MickThelosen/Smart-Experience-Sampling/README.md

# Smart Experience Sampling

## Setup

The user manual specifies the steps are needed to setup the system

Button B2 starts the ranging process
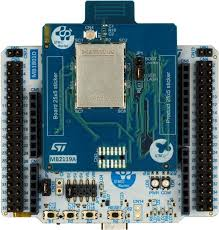
[picture p1: image.png]
