MickThelosen/Smart-Experience-Sampling/Clicker PCB/Clicker_PCB.jpg

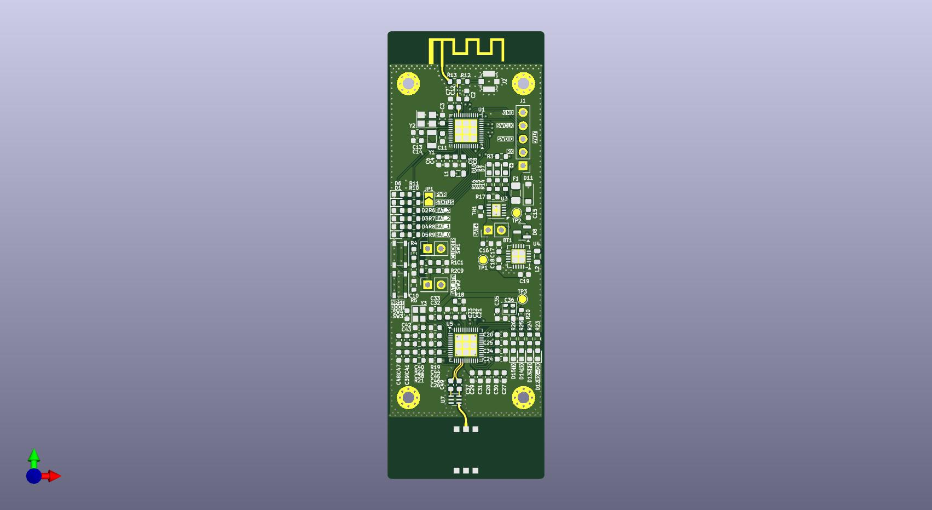
Clicker PCB/Clicker_PCB.jpg
