MickThelosen/Smart-Experience-Sampling/Software/Beacon Visualizer/plattegrond vitality hub 2024.png

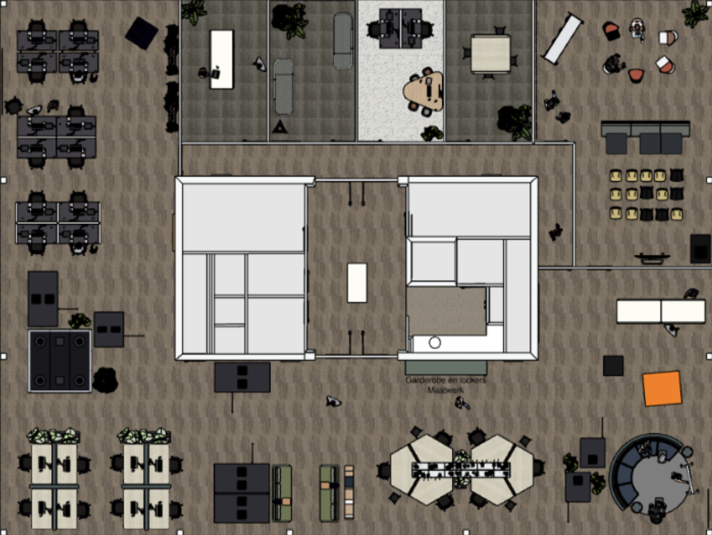
Software/Beacon Visualizer/plattegrond vitality hub 2024.png
