MickThelosen/Smart-Experience-Sampling/Order/SES Order/Mouser/Mouser Complete Order SES.xls

SHOPPING BASKET
This is not an invoice
06-Dec-24 06:26:31
 | Mouser No | Mfr. No | Manufacturer | Customer No | Description | RoHS | Lifecycle | Order Qty. | Price (EUR) | Ext.: (EUR)
1 | 358-SC1152 | SC1152 | Raspberry Pi |  | Wall Mount AC Adapters Raspberry Pi 5 27W USB-C PD PSU EU, White | RoHS Compliant | New Product | 1 | € 11,16 | € 11,16
2 | 358-SC1111 | SC1111 | Raspberry Pi |  | Single Board Computers Raspberry Pi5/4GB | RoHS Compliant | New Product | 1 | € 55,80 | € 55,80
3 | 358-SC1148 | SC1148 | Raspberry Pi |  | Heat Sinks Raspberry Pi Active Cooler | RoHS Compliant | New Product | 1 | € 4,65 | € 4,65
4 | 575-8581000310012000 | 858-10-003-10-012000 | Mill-Max |  | Headers & Wire Housings 4mm target Conn TH with inserts,no pins | RoHS Compliant |  | 10 | € 2,99 | € 29,90
5 | 575-8582200310011101 | 858-22-003-10-011101 | Mill-Max |  | Headers & Wire Housings Thru Hole 4mm Pitch Spring-Load Connect | RoHS Compliant |  | 10 | € 6,16 | € 61,60
6 | 358-SC0532 | SC0532 | Raspberry Pi |  | HDMI Cables 789RP-19041601B Micro-HDMI/M to HDMI-A/M Cable, 2M, Black | RoHS Compliant |  | 1 | € 5,58 | € 5,58
7 | 495-TXLN025-105 | TXLN 025-105 | TRACO Power |  | Switching Power Supplies 25W 5V 5A | RoHS Compliant |  | 1 | € 30,11 | € 30,11
8 | 467-SDSDQAB-016G | SDSDQAB-016G | SanDisk |  | Memory Cards 16GB UHS Class 4 MicroSD Card WD/SD | RoHS Compliant |  | 1 | € 11,99 | € 11,99
9 | 540-MX1A-E1NN | MX1A-E1NN | CHERRY |  | Pushbutton Switches Full Travel (Blue stem), Mech. KeyswitchClick Tactile Feel, 60cNNo LED, No DiodeFrame mount (no fixation pins) | RoHS Compliant |  | 10 | € 0,805 | € 8,05
10 | 540-MX1A-G1NA | MX1A-G1NA | CHERRY |  | Pushbutton Switches MX RGB, Brown Stem, Full Travel Mechanical KeyswitchSoft click Feel, 55cN, clear housingNo DiodeFrame Mount (no fixation pins) | RoHS Compliant |  | 10 | € 1,30 | € 13,00
11 | 12BHC186P-GR | 12BHC186P-GR | Eagle Plastic Devices |  | Cylindrical Battery Contacts, Clips, Holders & Springs 2X18650 PARALLEL CONNECTION | RoHS Compliant |  | 10 | € 3,34 | € 33,40
12 | 166-RVT121HVLNWCA0-B | SM-RVT121HVLNWCA0-B | Riverdi |  | TFT Displays & Accessories 12.1" HB,IPS,LVDS,aTouch CG, Optical Bonding, Anti-UV | RoHS Compliant | New Product | 1 | € 179,84 | € 179,84
13 | 71-CRCW06030000Z0EI | CRCW06030000Z0EI | Vishay |  | Thick Film Resistors - SMD D11/CRCW0603 0R0 ET2 e3 | RoHS Compliant By Exemption |  | 60 | € 0,027 | € 1,62
14 | 80-C0603C100K5HACTU | C0603C100K5HACTU | KEMET |  | Multilayer Ceramic Capacitors MLCC - SMD/SMT 50V 10pF 0603 X8R 0.1 | RoHS Compliant |  | 40 | € 0,019 | € 0,76
15 | 791-0603N120J500CT | 0603N120J500CT | Walsin |  | Multilayer Ceramic Capacitors MLCC - SMD/SMT 50 V 12 pF 5% C0G (NP0) 0603 - 55 C + 125 C | RoHS Compliant |  | 80 | € 0,013 | € 1,04
16 | 791-0603N180J250CT | 0603N180J250CT | Walsin |  | Multilayer Ceramic Capacitors MLCC - SMD/SMT 18pF, +-5%, 25V | RoHS Compliant |  | 20 | € 0,013 | € 0,26
17 | 791-0603N200J160CT | 0603N200J160CT | Walsin |  | Multilayer Ceramic Capacitors MLCC - SMD/SMT 20pF, +-5%, 16V | RoHS Compliant |  | 20 | € 0,027 | € 0,54
18 | 80-C0603C270J5GAC | C0603C270J5GAC | KEMET |  | Multilayer Ceramic Capacitors MLCC - SMD/SMT 50V 27pF C0G 0603 5% | RoHS Compliant |  | 20 | € 0,024 | € 0,48
19 | 791-0603B331K100CT | 0603B331K100CT | Walsin |  | Multilayer Ceramic Capacitors MLCC - SMD/SMT 330pF, +-10%, 10V | RoHS Compliant |  | 40 | € 0,009 | € 0,36
20 | 80-C0603C821K5RAC | C0603C821K5RAC | KEMET |  | Multilayer Ceramic Capacitors MLCC - SMD/SMT 50V 820pF X7R 0603 10% | RoHS Compliant |  | 20 | € 0,054 | € 1,08
21 | 791-0603B103J101CT | 0603B103J101CT | Walsin |  | Multilayer Ceramic Capacitors MLCC - SMD/SMT 0603 MLCC X7R 0.01 uF, +/- 5% 100 V T&R MH | RoHS Compliant |  | 20 | € 0,016 | € 0,32
22 | 80-C0603C104M4RAUTO | C0603C104M4RACAUTO | KEMET |  | Multilayer Ceramic Capacitors MLCC - SMD/SMT 16V 0.1uF X7R 0603 20% AEC-Q200 | RoHS Compliant |  | 440 | € 0,02 | € 8,80
23 | 963-MLAST168SB7105KT | MLAST168SB7105KTNA01 | TAIYO YUDEN |  | Multilayer Ceramic Capacitors MLCC - SMD/SMT 25V 1uF X7R 0603 10% Medical | RoHS Compliant |  | 40 | € 0,046 | € 1,84
24 | 810-MLZ2012N1R0LT000 | MLZ2012N1R0LT000 | TDK |  | Power Inductors - SMD 1 UH 20% | RoHS Compliant |  | 20 | € 0,055 | € 1,10
25 | 187-CL10A106MQ8NNND | CL10A106MQ8NNND | Samsung Electro-Mechanics |  | Multilayer Ceramic Capacitors MLCC - SMD/SMT 10uF+/-20% 6.3V X5R 0603 | RoHS Compliant |  | 40 | € 0,061 | € 2,44
26 | 810-MLZ2012M100WTD25 | MLZ2012M100WTD25 | TDK |  | Power Inductors - SMD 10uH 611mohms 350mA AEC-Q200 | RoHS Compliant |  | 20 | € 0,073 | € 1,46
27 | 187-CL10A226MP8NUNE | CL10A226MP8NUNE | Samsung Electro-Mechanics |  | Multilayer Ceramic Capacitors MLCC - SMD/SMT 22uF+/-20% 10V X5R 1 0603 | RoHS Compliant |  | 40 | € 0,092 | € 3,68
28 | 81-GRM188R60J476ME5D | GRM188R60J476ME15D | Murata |  | Multilayer Ceramic Capacitors MLCC - SMD/SMT 47 uF 6.3 VDC 20% 0603 X5R | RoHS Compliant |  | 20 | € 0,143 | € 2,86
29 | 755-ESR03EZPF2700 | ESR03EZPF2700 | ROHM Semiconductor |  | Thick Film Resistors - SMD 0603 270ohm 1% Anti Surge AEC-Q200 | RoHS Compliant By Exemption |  | 20 | € 0,114 | € 2,28
30 | 791-WR06X4700FTL | WR06X4700FTL | Walsin |  | Thick Film Resistors - SMD 470 OHM 1% | RoHS Compliant By Exemption |  | 140 | € 0,003 | € 0,42
31 | 71-CRCW06031K00FKEE | CRCW06031K00FKEE | Vishay |  | Thick Film Resistors - SMD D11/CRCW0603 100 1K 1% ET8 e3 | RoHS Compliant By Exemption |  | 20 | € 0,031 | € 0,62
32 | 71-CRCW060310K0FKED | CRCW060310K0FKED | Vishay |  | Thick Film Resistors - SMD D11/CRCW0603 100 10K 1% ET3 E3 | RoHS Compliant By Exemption |  | 100 | € 0,009 | € 0,90
33 | 667-ERT-J1VR103J | ERT-J1VR103J | Panasonic |  | NTC (Negative Temperature Coefficient) Thermistors 10K OHM 5% | RoHS Compliant |  | 20 | € 0,109 | € 2,18
34 | 660-RK73B1JTTD163J | RK73B1JTTD163J | KOA Speer |  | Thick Film Resistors - SMD 16K OHM 5% | RoHS Compliant By Exemption |  | 20 | € 0,01 | € 0,20
35 | 603-RT0603FRE13100KL | RT0603FRE13100KL | YAGEO |  | Thin Film Resistors - SMD 1/10W 100K ohm 1% 50ppm | RoHS Compliant By Exemption |  | 20 | € 0,015 | € 0,30
36 | 732-22532MF1Z-ACX | TSX-3225 32.0000MF10Z-ACX | Epson |  | Crystals TSX-3225 32.0000MF10Z-ACX: XTAL +/-10PPM +/-10PPM-20 75C 9.0PF ANY TR | RoHS Compliant |  | 20 | € 0,684 | € 13,68
37 | 815-ABM1016538.4MT3 | ABM10-165-38.400MHz-T3 | ABRACON |  | Crystals 38.4 MHZ OSC MEMS H/LVCMOS | RoHS Compliant |  | 20 | € 1,01 | € 20,20
38 | 603-RT0603DRD0711KL | RT0603DRD0711KL | YAGEO |  | Thin Film Resistors - SMD 11K OHM .5% 25PPM 1/10W | RoHS Compliant By Exemption |  | 20 | € 0,045 | € 0,90
39 | 80-C0603C129B4HACTU | C0603C129B4HACTU | KEMET |  | Multilayer Ceramic Capacitors MLCC - SMD/SMT 16V 1.2pF X8R 0603 0.1pF | RoHS Compliant |  | 20 | € 0,05 | € 1,00
40 | 187-CL10B225KP8NNNC | CL10B225KP8NNNC | Samsung Electro-Mechanics |  | Multilayer Ceramic Capacitors MLCC - SMD/SMT 2.2uF+/-10% 10V X7R 0603 | RoHS Compliant |  | 20 | € 0,037 | € 0,74
41 | 963-JMK107BJ475MA-T | JMK107BJ475MA-T | TAIYO YUDEN |  | Multilayer Ceramic Capacitors MLCC - SMD/SMT RPLCMT PN 963-MSASJ105BB5475MF 6.3V 4.7uF X5R 0603 20 % | RoHS Compliant |  | 80 | € 0,039 | € 3,12
42 | 791-RMC1/16-512JTP | RMC1/16-512JTP | Kamaya |  | Thick Film Resistors - SMD 0603 5K1 5% | RoHS Compliant By Exemption |  | 100 | € 0,004 | € 0,40
43 | 78-BZT52C5V6-E3-08 | BZT52C5V6-E3-08 | Vishay |  | Zener Diodes 5.6 Volt 0.5W 5% | RoHS Compliant |  | 20 | € 0,08 | € 1,60
44 | 963-AH086M555003-T | AH086M555003-T | TAIYO YUDEN |  | Antennas 963-TSA5NA6L5G55NS00 RPLCMT PN 3.5 - 5.6GHZ WIMAX | RoHS Compliant |  | 20 | € 5,31 | € 106,20
45 | 583-BAT54C | BAT54C | Rectron |  | Schottky Diodes & Rectifiers SOT23 0.2A 30V Schot tky Dblr | RoHS Compliant |  | 20 | € 0,246 | € 4,92
46 | 611-PTS810SJS250SMTR | PTS810SJS250SMTRLFS | C&K Switches |  | Tactile Switches SWITCH TACTILE | RoHS Compliant | Factory Special Order | 40 | € 0,345 | € 13,80
47 | 772-DW1000-I-TR13 | DW1000-I-TR13 | Qorvo |  | RF Transceiver DW1000 UWB Transceiver IC | RoHS Compliant |  | 20 | € 10,40 | € 208,00
48 | 710-150060GS75000 | 150060GS75000 | Wurth Elektronik |  | Standard LEDs - SMD WL-SMCW SMDMono TpVw Waterclr 0603 Green | RoHS Compliant |  | 100 | € 0,113 | € 11,30
49 | 810-HHM1595A1 | HHM1595A1 | TDK |  | Signal Conditioning LTCC BALUN 3000-8000MHz | RoHS Compliant |  | 20 | € 0,315 | € 6,30
50 | 968-ISL91127IRAZ-T | ISL91127IRAZ-T | Renesas Electronics |  | Switching Voltage Regulators High Efficiency Buck/BoostRegulator with 4.25A Switches in a | RoHS Compliant |  | 20 | € 1,76 | € 35,20
51 | 579-MCP73833T-AMI/MF | MCP73833T-AMI/MF | Microchip |  | Battery Management Charge Management Controllers | RoHS Compliant |  | 20 | € 0,977 | € 19,54
52 | 511-MLPF-NRG-01D3 | MLPF-NRG-01D3 | STMicroelectronics |  | Signal Conditioning 2.4 GHz Low Pass Filter matched to BLUENRG-LP-LPS | RoHS Compliant |  | 20 | € 0,238 | € 4,76
53 | 710-150060RS75000 | 150060RS75000 | Wurth Elektronik |  | Standard LEDs - SMD WL-SMCW SMDMono TpVw Waterclr 0603 Red | RoHS Compliant |  | 60 | € 0,132 | € 7,92
54 | 710-150060AS75000 | 150060AS75000 | Wurth Elektronik |  | Standard LEDs - SMD WL-SMCW Mono LED Waterclear 0603Amber | RoHS Compliant |  | 40 | € 0,139 | € 5,56
55 | 710-150060BS75000 | 150060BS75000 | Wurth Elektronik |  | Standard LEDs - SMD WL-SMCW SMDMono TpVw Waterclr 0603 Blue | RoHS Compliant |  | 60 | € 0,144 | € 8,64
56 | 511-STM32WB07CCV6TR | STM32WB07CCV6TR | STMicroelectronics |  | RF System on a Chip - SoC Ultra-low-power Arm Cortex-M0+ MCU 64 MHz 256 Kbytes Flash 64 Kbytes RAM BLE 5.4 | RoHS Compliant | New Product | 20 | € 2,70 | € 54,00
57 | 815-ABS07L-32.7-T | ABS07L-32.768kHz-T | ABRACON |  | Crystals 32.768 KHZ 12.5PF SMD | RoHS Compliant |  | 20 | € 1,20 | € 24,00
58 | 504-PTS18126V260 | PTS18126V260 | Eaton |  | Resettable Fuses - PPTC PPTC 1812 6V 2.6A SMD | RoHS Compliant |  | 20 | € 0,152 | € 3,04
59 | 910-SMDLTB35T4 | SMDLTB35T4 | Chip Quik |  | Solder Solder Paste Sn60/Bi40 T4 35g Syringe 87% Metal Low-Temperature | RoHS Compliant | New Product | 1 | € 24,13 | € 24,13
60 | 910-SMD291/30CC | SMD291/30CC | Chip Quik |  | Soldering Flux TACK FLUX NO CLEAN 30CC SYRINGE | RoHS Compliant |  | 1 | € 34,19 | € 34,19
By submitting your order you agree to these terms and conditions. (https://nl.mouser.com/saleterms) |  |  |  |  |  |  |  |  | Merchandise: | € 1.093,76
Prices are reflected at the date and time shown. |  |  |  |  |  |  |  |  | Delivery Charge: | € 0,00
