MickThelosen/Smart-Experience-Sampling/3D Design Files/Clicker V3.1.step

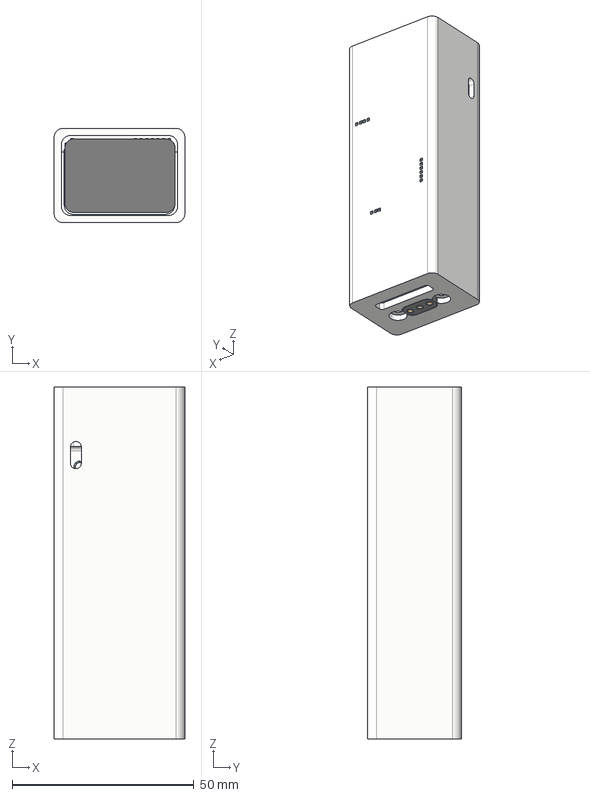
[picture p4: CAD file, 2025-01-19]
3D Design Files/Clicker V3.1.step
36.0 x 26.0 x 96.9 mm
MX Öá °´¼ü¡ä_¨¹ ___¡§1
MX Öá ÖáÌå¨¢¨¬ _¡§¡é¡§__
MXÖá ÖáÌå µ×²¿ ¦Ì¡ Á2__Ä¬ÈÏ_¨¢2____¨¨_
Õë½Å___Ä¬ÈÏ__¨¨ _
LED_0603_1608Metric_1 x 13
Clicker_PCB_PCB
Battery
Button
Outer Shell
Tray
mill-max-858-10-003-10-002000_P8XX-18-014-16-08000X(P803-18-014-16-08 0000)
mill-max-858-10-003-10-002000_1969-X(1969-1-00-15-00-00-03-0) x 3
