MickThelosen/Smart-Experience-Sampling/Clicker PCB/Clicker_PCB.step

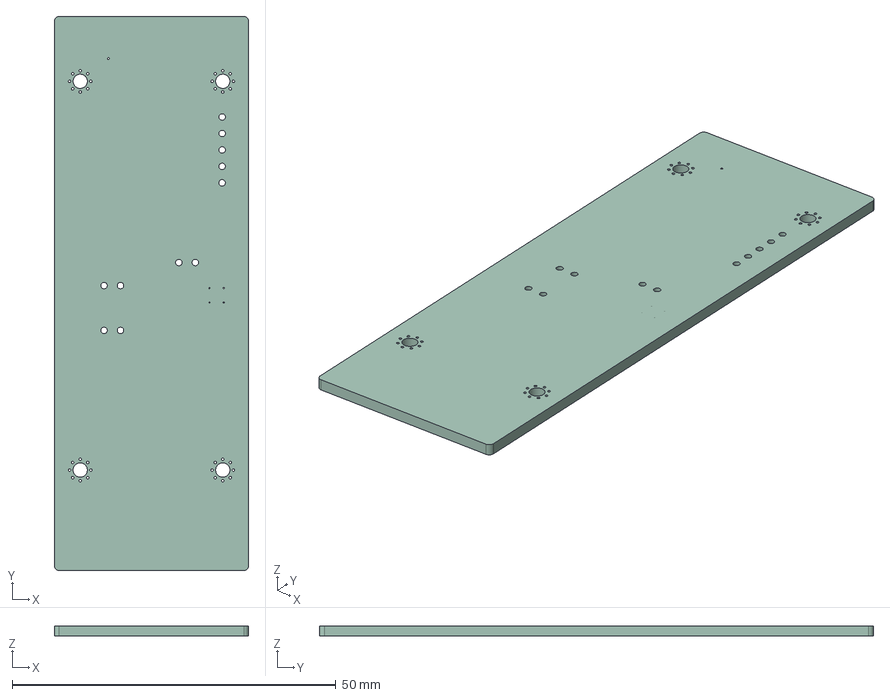
[picture p5: CAD file, 2025-01-19]
Clicker PCB/Clicker_PCB.step
30.0 x 85.5 x 1.60 mm
