MickThelosen/Smart-Experience-Sampling/(list of files, cad)

Other CAD files:
3D Design Files/Clicker V3.1.f3d
