MickThelosen/Smart-Experience-Sampling/Clicker PCB/plots/Clicker_PCB__Assembly.pdf

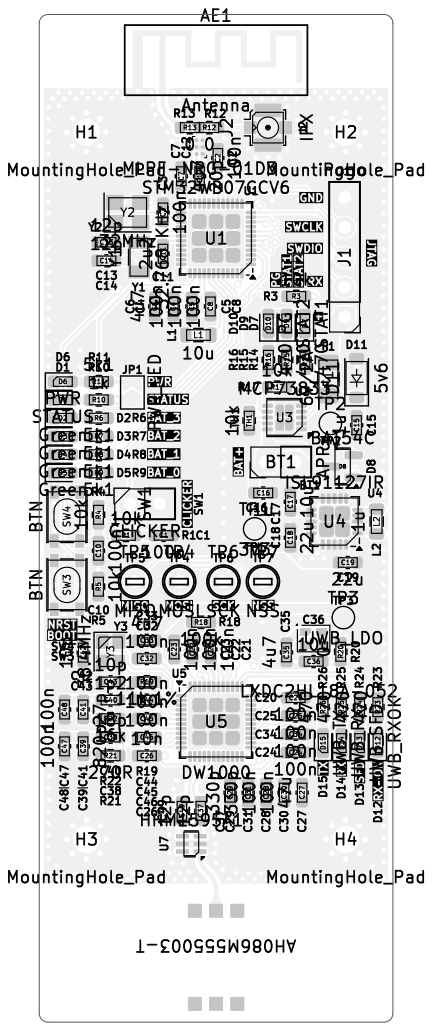
[picture p17: page 1]

1 | 2 | 3 | 4 | 5 | 6

A

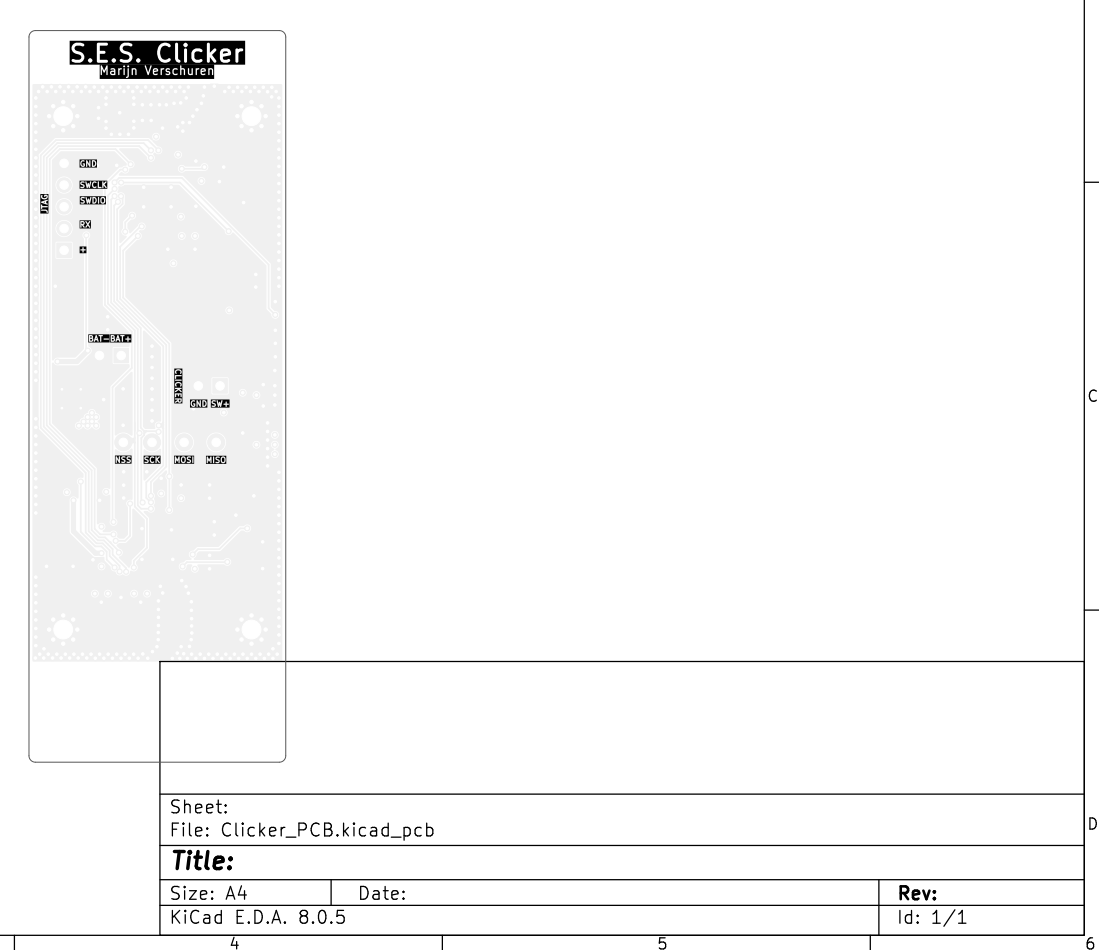
[picture p18: page 2]
D Date: KiCad; E.D.A. 8.0.5 Size: A4; Rev:

Id: 1/1 Title: File: Clicker_PCB.kicad_pcb Sheet:
