MickThelosen/Smart-Experience-Sampling/Clicker PCB/plots/Clicker_PCB.pdf

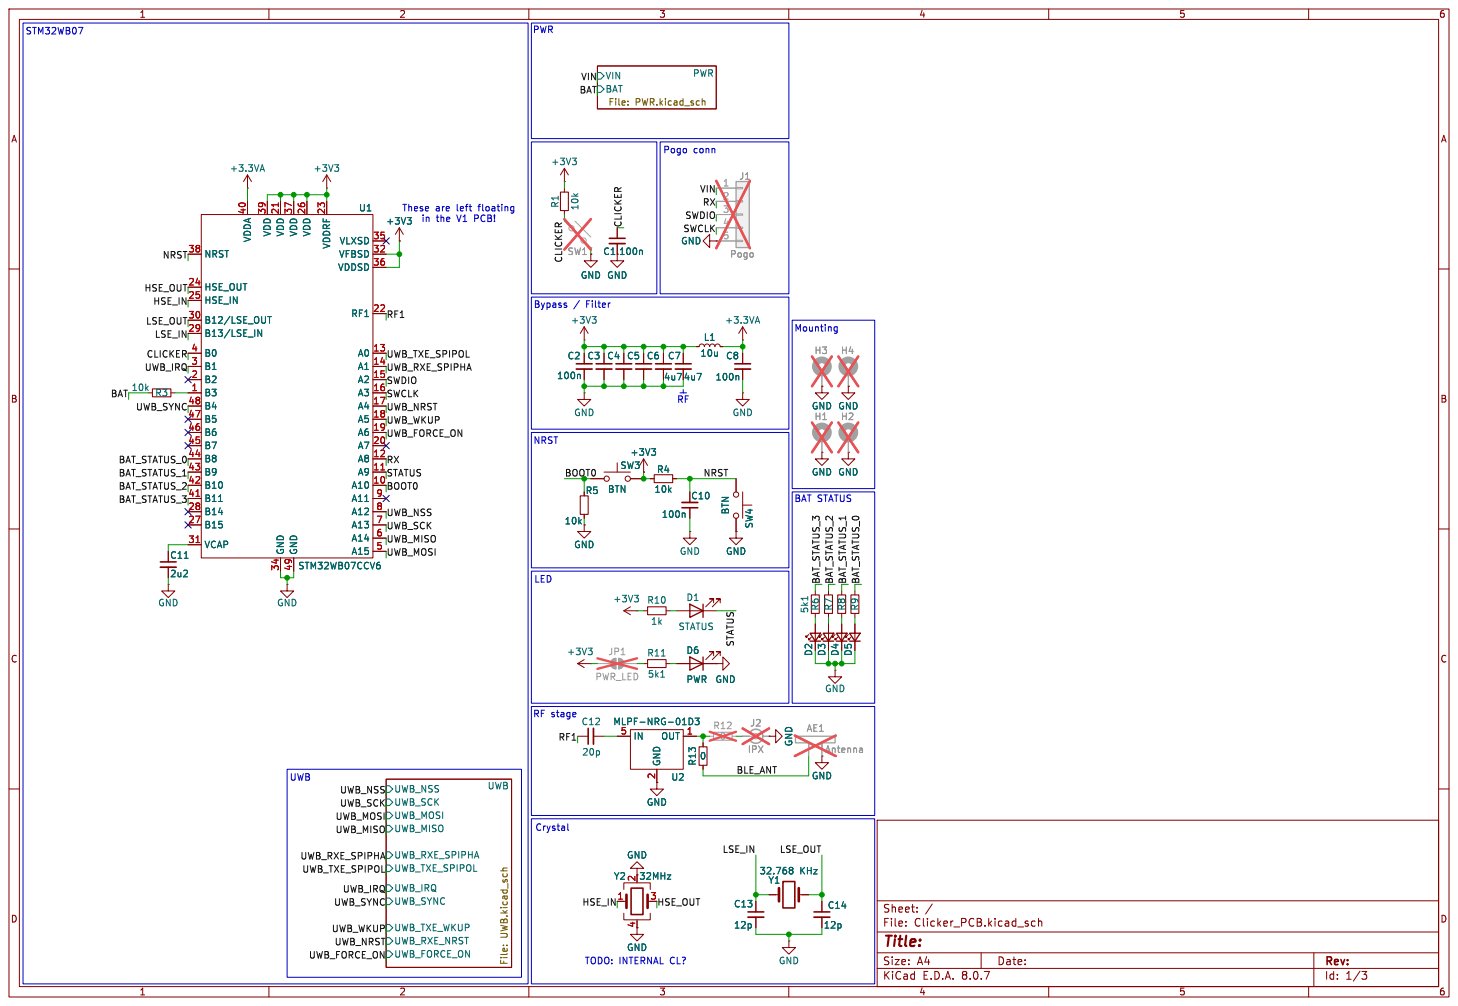
[picture p19: page 1]

These are left floating

Id: 1/3 Title: File: Clicker_PCB.kicad_sch Sheet: / UWB_RXE_SPIPHA UWB_TXE_SPIPOL UWB_SYNC

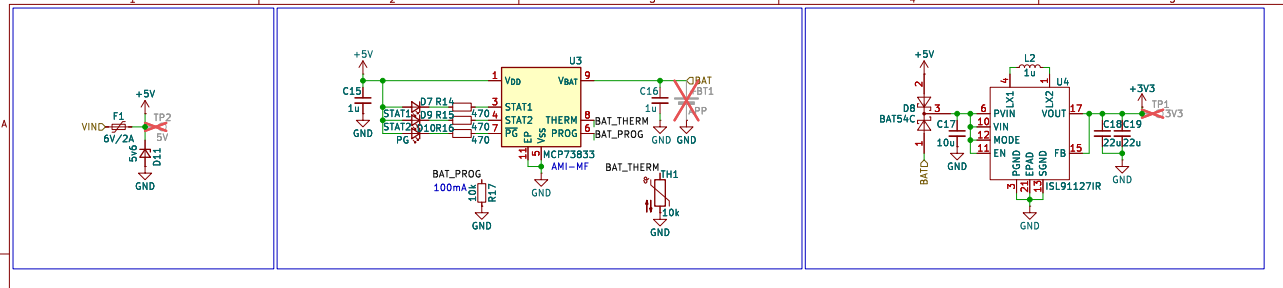
[picture p20: page 2]

1 VIN 10 EN 11 MODE 12 SGND 13 FB 15 VOUT 17 EPAD 21 PGND

Id: 2/3 Title: File: PWR.kicad_sch Sheet: /PWR/

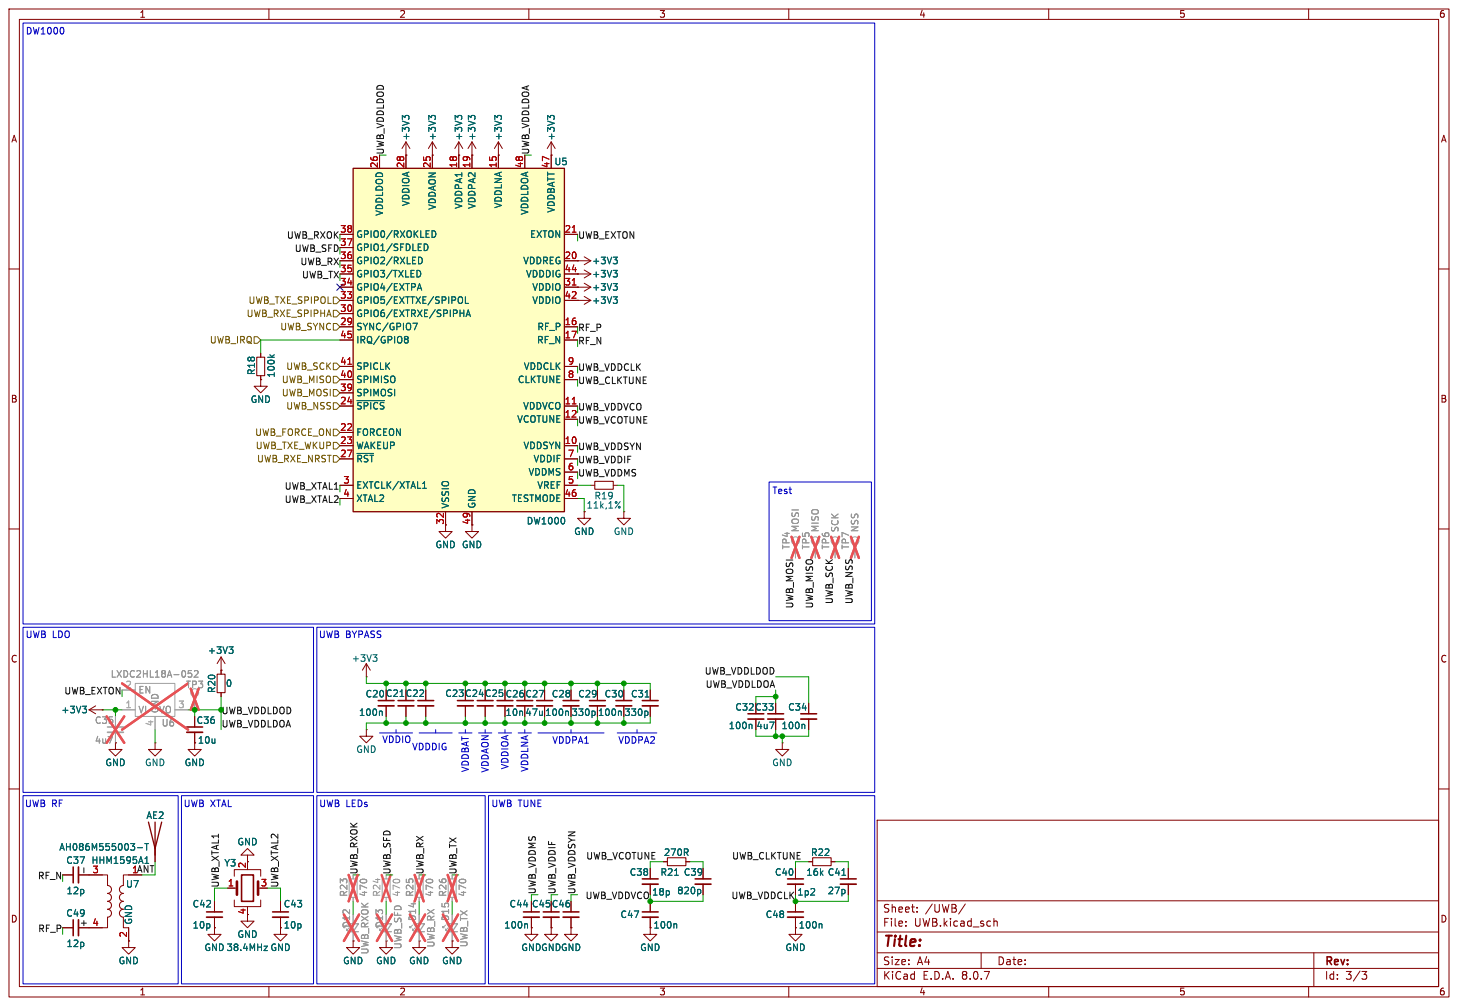
[picture p21: page 3]

Id: 3/3 Title: File: UWB.kicad_sch Sheet: /UWB/ GND GND
