MickThelosen/Smart-Experience-Sampling/Clicker PCB/Clicker_PCB.kicad_pcb

## KiCad design Clicker PCB/Clicker_PCB.kicad_pcb (2025-01-27)

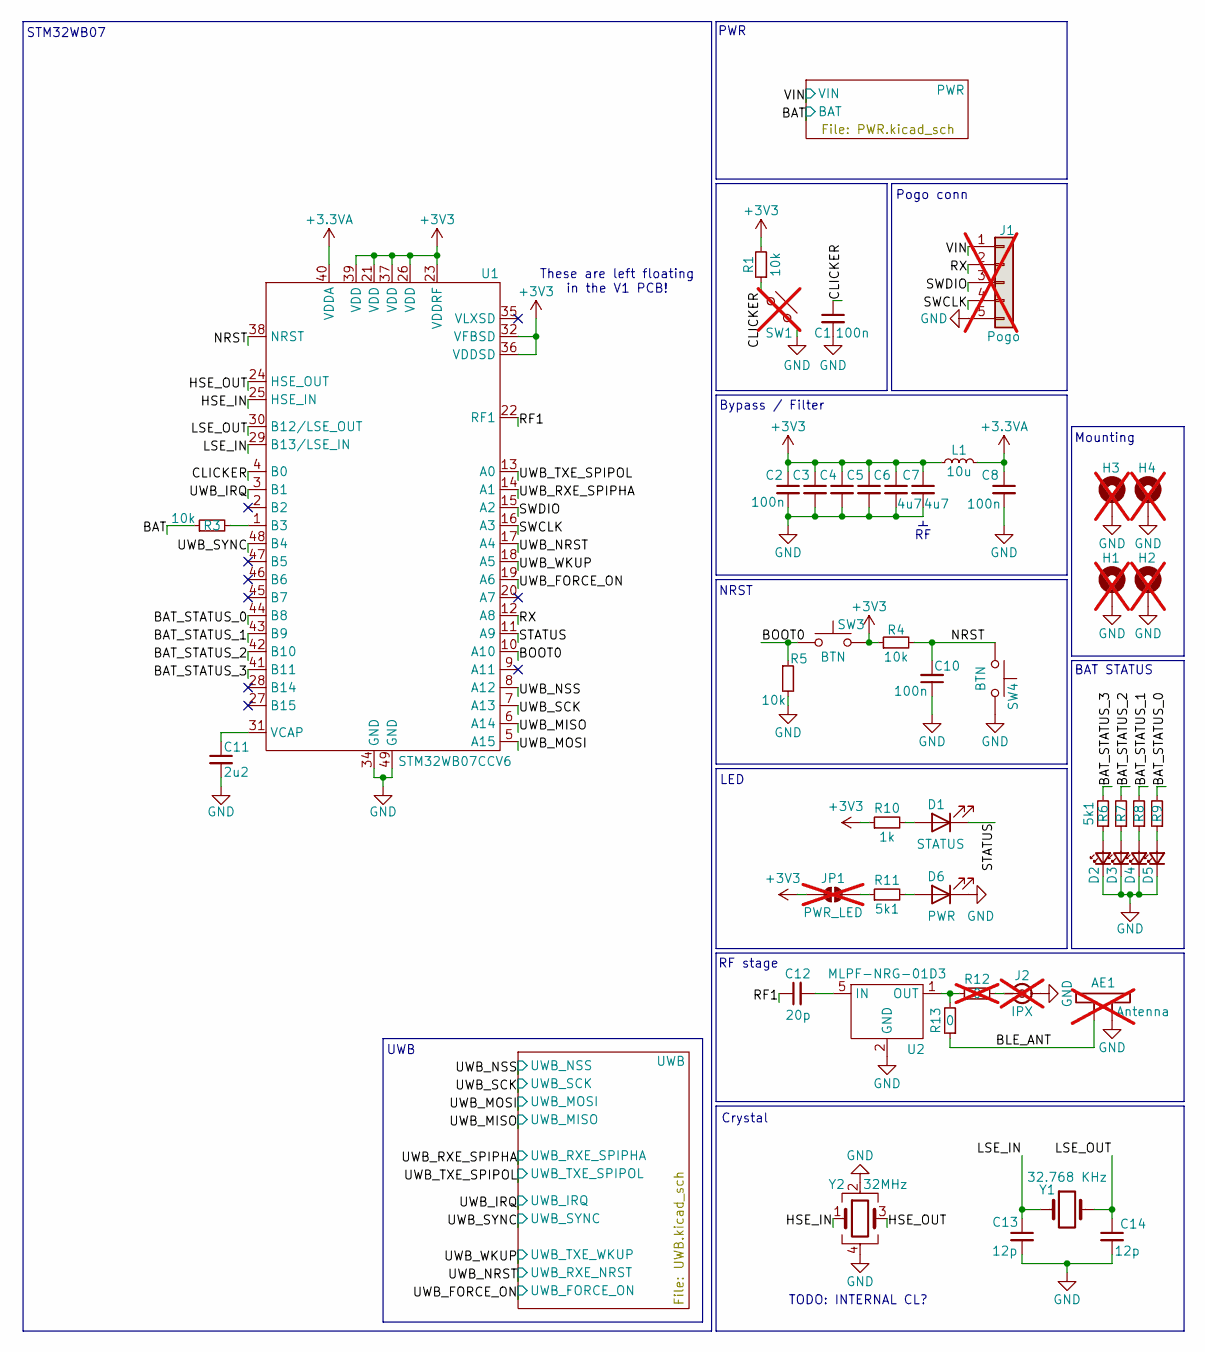
[picture p36: schematic Clicker_PCB.kicad_sch]

Parts:
AE1: Antenna; Texas_SWRA117D_2.4GHz_Right; not fitted
C1, C2, C3, C4, C5, C8, C10: 100n; C_0603_1608Metric; mouser 80-C0603C104M4RAUTO
C6, C7: 4u7; C_0603_1608Metric; mouser 963-JMK107BJ475MA-T
C11: 2u2; C_0603_1608Metric; mouser 187-CL10B225KP8NNNC
C12: 20p; C_0603_1608Metric; LCSC C1547
C13, C14: 12p; C_0603_1608Metric; LCSC C1547
D1: STATUS; LED_0603_1608Metric; mouser 710-150060BS75000
D2, D3, D4, D5: Green; LED_0603_1608Metric; mouser 710-150060GS75000
D6: PWR; LED_0603_1608Metric; mouser 710-150060RS75000
H1, H2, H3, H4: MountingHole_Pad; MountingHole_2.2mm_M2_Pad_Via; not fitted
J1: Pogo; PinHeader_1x05_P2.54mm_Vertical; not fitted
J2: IPX; U.FL_Molex_MCRF_73412-0110_Vertical; not fitted
JP1: PWR_LED; SolderJumper-2_P1.3mm_Open_TrianglePad1.0x1.5mm; not fitted
L1: 10u; L_0805_2012Metric; LCSC C139245
R1, R3, R4, R5: 10k; R_0603_1608Metric; mouser 71-CRCW060310K0FKED
R6, R7, R8, R9, R11: 5k1; R_0603_1608Metric; mouser 791-RMC1/16-512JTP
R10: 1k; R_0603_1608Metric; mouser 71-CRCW06031K00FKEE
R12: 0; R_0603_1608Metric; mouser 71-CRCW06030000Z0EI; not fitted
R13: 0; R_0603_1608Metric; mouser 71-CRCW06030000Z0EI
SW1: CLICKER; PinHeader_2x01_P2.54mm_Vertical; not fitted
SW3, SW4: BTN; SW_SPST_PTS810; LCSC C2681476
U1: STM32WB07CCV6; QFN-48-1EP_6x6mm_P0.4mm_EP4.3x4.3mm; mouser 511-STM32WB07CCV6TR
U2: MLPF-NRG-01D3; CSPG; mouser 511-MLPF-NRG-01D3
Y1: 32.768 KHz; Crystal_SMD_3215-2Pin_3.2x1.5mm; LCSC C32346
Y2: 32MHz; Crystal_SMD_3225-4Pin_3.2x2.5mm; LCSC C9006

Connections:
+3.3VA: C8.1, L1.2, U1.40 (VDDA)
+3V3: C2.1, C3.1, C4.1, C5.1, C6.1, C7.1, JP1.1 (A), L1.1, R1.2, R4.1, R10.1, SW3.2, U1.21 (VDD), U1.23 (VDDRF), U1.26 (VDD), U1.32 (VFBSD), U1.36 (VDDSD), U1.37 (VDD), U1.39 (VDD); also elsewhere on the board
/BAT: R3.1; also elsewhere on the board
/BAT_STATUS_0: R9.2, U1.44 (B8)
/BAT_STATUS_1: R8.2, U1.43 (B9)
/BAT_STATUS_2: R7.2, U1.42 (B10)
/BAT_STATUS_3: R6.2, U1.41 (B11)
/BLE_ANT: AE1.1, R13.1
/BOOT0: R5.1, SW3.1, U1.10 (A10)
/CLICKER: C1.1, R1.1, SW1.1, U1.4 (B0)
/HSE_IN: U1.25 (HSE_IN), Y2.1
/HSE_OUT: U1.24 (HSE_OUT), Y2.3
/LSE_IN: C13.1, U1.29 (B13/LSE_IN), Y1.1
/LSE_OUT: C14.1, U1.30 (B12/LSE_OUT), Y1.2
/NRST: C10.2, R4.2, SW4.1, U1.38 (NRST)
/RF1: C12.1, U1.22 (RF1)
/RX: J1.2, U1.12 (A8)
/STATUS: D1.1 (K), U1.11 (A9)
/SWCLK: J1.4, U1.16 (A3)
/SWDIO: J1.3, U1.15 (A2)
/UWB_FORCE_ON: U1.19 (A6); also elsewhere on the board
/UWB_IRQ: U1.3 (B1); also elsewhere on the board
/UWB_MISO: U1.6 (A14); also elsewhere on the board
/UWB_MOSI: U1.5 (A15); also elsewhere on the board
/UWB_NRST: U1.17 (A4); also elsewhere on the board
/UWB_NSS: U1.8 (A12); also elsewhere on the board
/UWB_RXE_SPIPHA: U1.14 (A1); also elsewhere on the board
/UWB_SCK: U1.7 (A13); also elsewhere on the board
/UWB_SYNC: U1.48 (B4); also elsewhere on the board
/UWB_TXE_SPIPOL: U1.13 (A0); also elsewhere on the board
/UWB_WKUP: U1.18 (A5); also elsewhere on the board
/VIN: J1.1; also elsewhere on the board
GND: AE1.2, C1.2, C2.2, C3.2, C4.2, C5.2, C6.2, C7.2, C8.2, C10.1, C11.2, C13.2, C14.2, D2.1 (K), D3.1 (K), D4.1 (K), D5.1 (K), D6.1 (K), H1.1, H2.1, H3.1, H4.1, J1.5, J2.2 (Ext), R5.2, SW1.2, SW4.2, U1.34 (GND), U1.49 (GND), U2.2 (GND), U2.3 (GND), U2.4 (GND), U2.6 (GND), Y2.2, Y2.4; also elsewhere on the board
unnamed: D1.2 (A), R10.2
unnamed: D2.2 (A), R6.1
unnamed: D3.2 (A), R7.1
unnamed: D4.2 (A), R8.1
unnamed: D5.2 (A), R9.1
unnamed: D6.2 (A), R11.2
unnamed: J2.1 (In), R12.2
unnamed: JP1.2 (B), R11.1
unnamed: R3.2, U1.1 (B3)
unnamed: C11.1, U1.31 (VCAP)
unnamed: C12.2, U2.5 (IN)
unnamed: R12.1, R13.2, U2.1 (OUT)

Notes on the sheet:
Pogo conn
TODO: INTERNAL CL?
BAT STATUS
STM32WB07
These are left floating in the V1 PCB!
LED
Crystal
UWB
PWR
NRST
RF stage
Mounting
Bypass / Filter

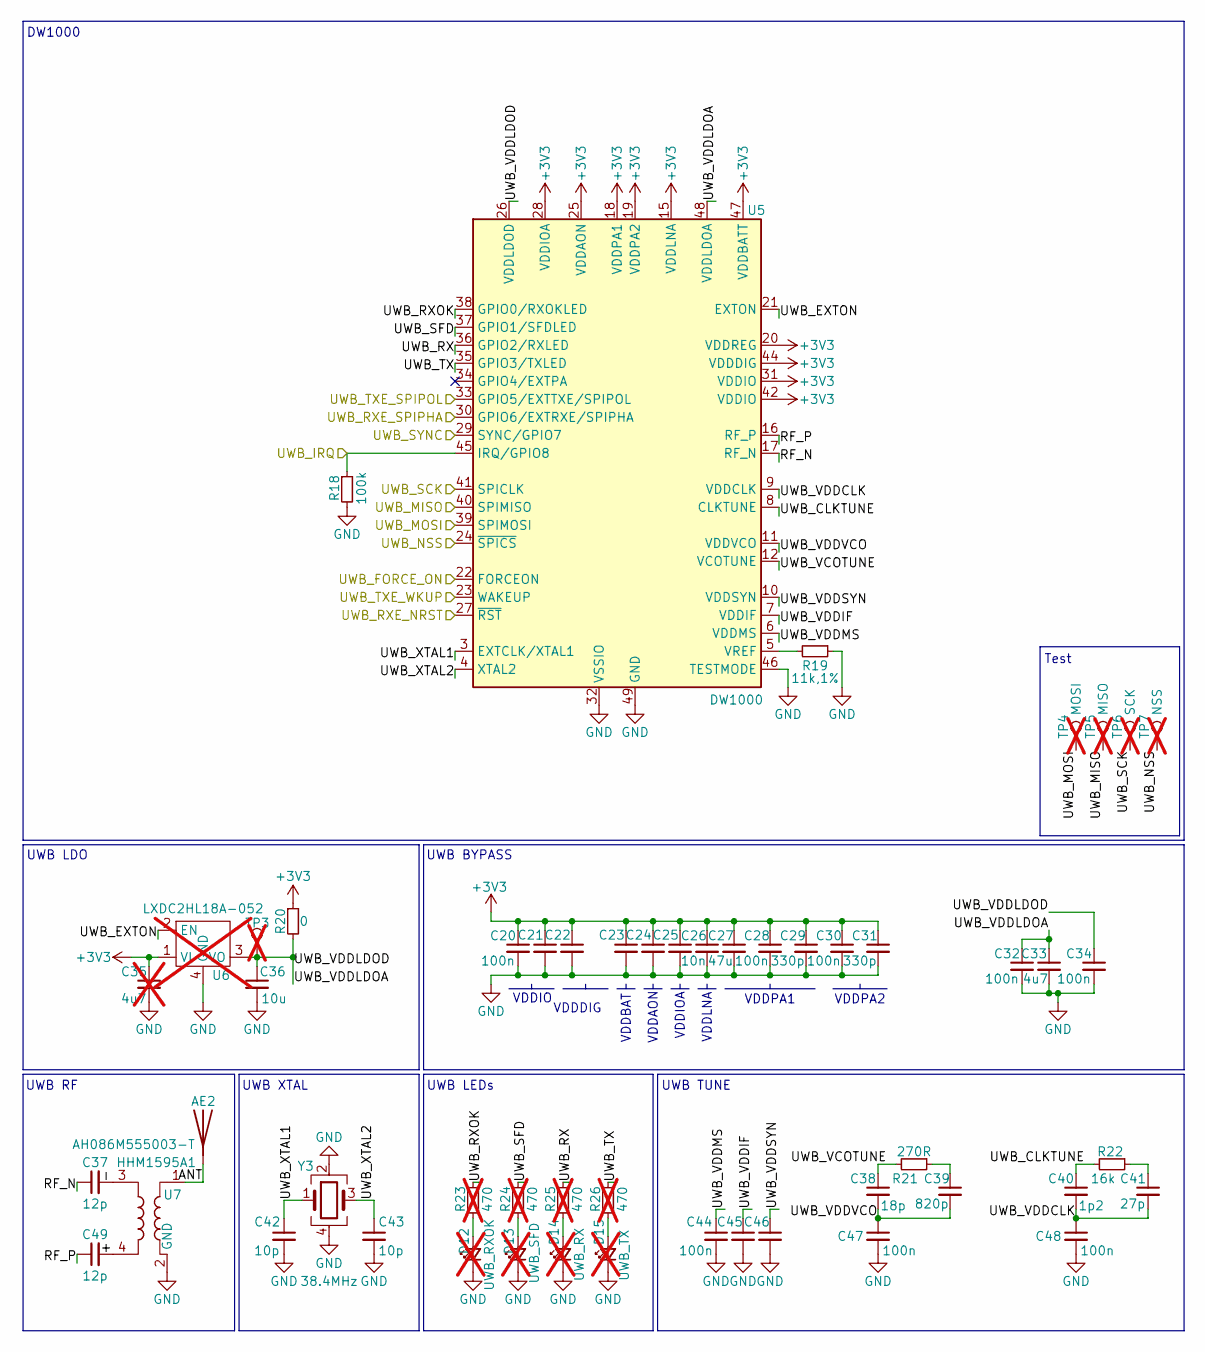
[picture p37: schematic UWB.kicad_sch]

Parts:
AE2: AH086M555003-T; AH086Mx; mouser 963-AH086M555003-T
C20, C21, C22, C23, C24, C25, C28, C30, C32, C34, C44, C45, C46, C47, C48: 100n; C_0603_1608Metric; LCSC C1547
C26: 10n; C_0603_1608Metric; LCSC C1547
C27: 47u; C_0603_1608Metric; LCSC C1547
C29, C31: 330p; C_0603_1608Metric; LCSC C1547
C33: 4u7; C_0603_1608Metric; LCSC C1547
C35: 4u7; C_0603_1608Metric; LCSC C1547; not fitted
C36: 10u; C_0603_1608Metric; LCSC C1547
C37, C49: 12p; C_0603_1608Metric; mouser 791-0603N120J500CT
C38: 18p; C_0603_1608Metric; LCSC C1547
C39: 820p; C_0603_1608Metric; LCSC C1547
C40: 1p2; C_0603_1608Metric; LCSC C1547
C41: 27p; C_0603_1608Metric; LCSC C1547
C42, C43: 10p; C_0603_1608Metric; LCSC C1547
D12: UWB_RXOK; LED_0603_1608Metric; mouser 710-150060GS75000; not fitted
D13: UWB_SFD; LED_0603_1608Metric; mouser 710-150060RS75000; not fitted
D14: UWB_RX; LED_0603_1608Metric; mouser 710-150060BS75000; not fitted
D15: UWB_TX; LED_0603_1608Metric; mouser 710-150060BS75000; not fitted
R18: 100k; R_0603_1608Metric; mouser 603-RT0603FRE13100KL
R19: 11k,1%; R_0603_1608Metric; mouser 603-RT0603DRD0711KL
R20: 0; R_0603_1608Metric; mouser 71-CRCW06030000Z0EI
R21: 270R; R_0603_1608Metric; mouser 755-ESR03EZPF2700
R22: 16k; R_0603_1608Metric; mouser 660-RK73B1JTTD163J
R23, R24, R25, R26: 470; R_0603_1608Metric; mouser 791-WR06X4700FTL; not fitted
TP3: UWB_LDO; TestPoint_Pad_D1.5mm; not fitted
TP4: MOSI; TestPoint_Keystone_5000-5004_Miniature; not fitted
TP5: MISO; TestPoint_Keystone_5000-5004_Miniature; not fitted
TP6: SCK; TestPoint_Keystone_5000-5004_Miniature; not fitted
TP7: NSS; TestPoint_Keystone_5000-5004_Miniature; not fitted
U5: DW1000; QFN-48-1EP_6x6mm_P0.4mm_EP4.2x4.2mm; mouser 772-DW1000-I-TR13
U6: LXDC2HL18A-052; LXDC2HL; mouser 81-LXDC2HL18A-052; not fitted
U7: HHM1595A1; mouser 810-HHM1595A1
Y3: 38.4MHz; Crystal_SMD_2520-4Pin_2.5x2.0mm; mouser 815-ABM1016538.4MT3

Connections:
+3V3: C20.1, C21.1, C22.1, C23.1, C24.1, C25.1, C26.1, C27.1, C28.1, C29.1, C30.1, C31.1, C35.1, R20.1, U5.15 (VDDLNA), U5.18 (VDDPA1), U5.19 (VDDPA2), U5.20 (VDDREG), U5.25 (VDDAON), U5.28 (VDDIOA), U5.31 (VDDIO), U5.42 (VDDIO), U5.44 (VDDDIG), U5.47 (VDDBATT), U6.1 (VI); also elsewhere on the board
/UWB/+: C49.2, U7.4
/UWB/-: C37.2, U7.3
/UWB/ANT: AE2.1 (A), U7.1
/UWB/RF_N: C37.1, U5.17 (RF_N)
/UWB/RF_P: C49.1, U5.16 (RF_P)
/UWB/UWB_CLKTUNE: C40.1, R22.2, U5.8 (CLKTUNE)
/UWB/UWB_EXTON: U5.21 (EXTON), U6.2 (EN)
/UWB/UWB_RX: R25.1, U5.36 (GPIO2/RXLED)
/UWB/UWB_RXOK: R23.1, U5.38 (GPIO0/RXOKLED)
/UWB/UWB_SFD: R24.1, U5.37 (GPIO1/SFDLED)
/UWB/UWB_TX: R26.1, U5.35 (GPIO3/TXLED)
/UWB/UWB_VCOTUNE: C38.1, R21.2, U5.12 (VCOTUNE)
/UWB/UWB_VDDCLK: C40.2, C41.2, C48.1, U5.9 (VDDCLK)
/UWB/UWB_VDDIF: C45.1, U5.7 (VDDIF)
/UWB/UWB_VDDLDOA: C32.1, C33.1, C34.1, C36.1, R20.2, TP3.1, U5.26 (VDDLDOD), U5.48 (VDDLDOA), U6.3 (VO)
/UWB/UWB_VDDMS: C44.1, U5.6 (VDDMS)
/UWB/UWB_VDDSYN: C46.1, U5.10 (VDDSYN)
/UWB/UWB_VDDVCO: C38.2, C39.2, C47.1, U5.11 (VDDVCO)
/UWB/UWB_XTAL1: C42.1, U5.3 (EXTCLK/XTAL1), Y3.1
/UWB/UWB_XTAL2: C43.1, U5.4 (XTAL2), Y3.3
/UWB_FORCE_ON: U5.22 (FORCEON); also elsewhere on the board
/UWB_IRQ: R18.1, U5.45 (IRQ/GPIO8); also elsewhere on the board
/UWB_MISO: TP5.1, U5.40 (SPIMISO); also elsewhere on the board
/UWB_MOSI: TP4.1, U5.39 (SPIMOSI); also elsewhere on the board
/UWB_NRST: U5.27 (~RST); also elsewhere on the board
/UWB_NSS: TP7.1, U5.24 (~SPICS); also elsewhere on the board
/UWB_RXE_SPIPHA: U5.30 (GPIO6/EXTRXE/SPIPHA); also elsewhere on the board
/UWB_SCK: TP6.1, U5.41 (SPICLK); also elsewhere on the board
/UWB_SYNC: U5.29 (SYNC/GPIO7); also elsewhere on the board
/UWB_TXE_SPIPOL: U5.33 (GPIO5/EXTTXE/SPIPOL); also elsewhere on the board
/UWB_WKUP: U5.23 (WAKEUP); also elsewhere on the board
GND: C20.2, C21.2, C22.2, C23.2, C24.2, C25.2, C26.2, C27.2, C28.2, C29.2, C30.2, C31.2, C32.2, C33.2, C34.2, C35.2, C36.2, C42.2, C43.2, C44.2, C45.2, C46.2, C47.2, C48.2, D12.1 (K), D13.1 (K), D14.1 (K), D15.1 (K), R18.2, R19.1, U5.32 (VSSIO), U5.43 (VSSIO), U5.46 (TESTMODE), U5.49 (GND), U6.4 (GND), U7.2 (GND), U7.5 (GND), Y3.2, Y3.4; also elsewhere on the board
unnamed: C39.1, R21.1
unnamed: C41.1, R22.1
unnamed: D12.2 (A), R23.2
unnamed: D13.2 (A), R24.2
unnamed: D14.2 (A), R25.2
unnamed: D15.2 (A), R26.2
unnamed: R19.2, U5.5 (VREF)

Notes on the sheet:
VDDIO
VDDBAT
VDDDIG
DW1000
VDDLNA
UWB RF
UWB TUNE
UWB XTAL
UWB LDO
UWB BYPASS
VDDAON
VDDIOA
Test
VDDPA2
VDDPA1
UWB LEDs

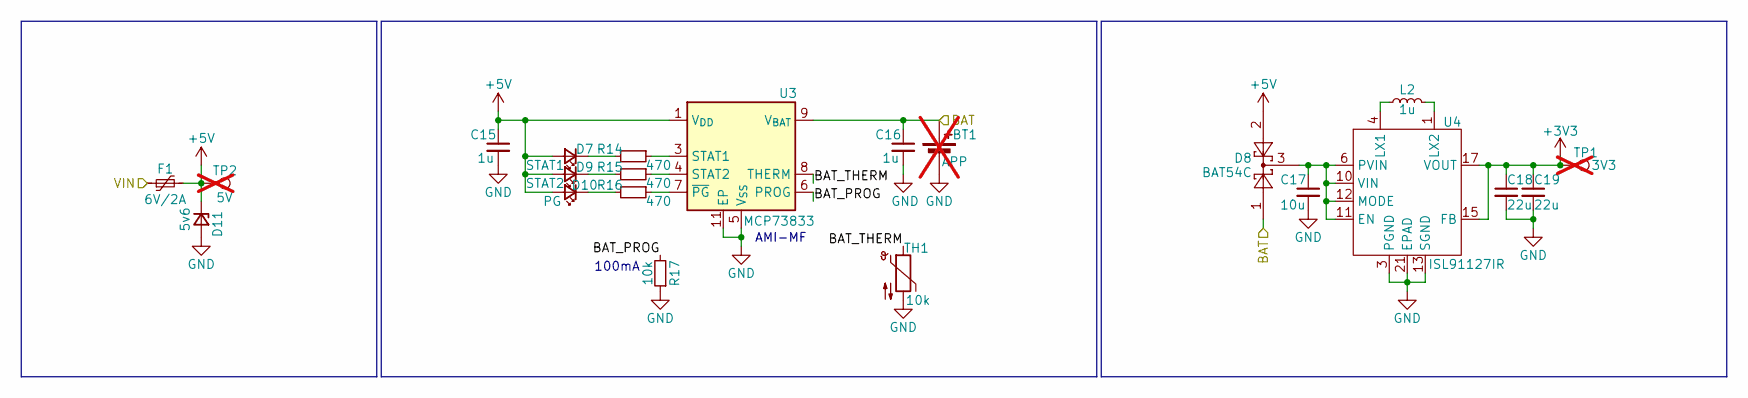
[picture p38: schematic PWR.kicad_sch]

Parts:
BT1: APP; PinHeader_1x02_P2.54mm_Vertical; not fitted
C15, C16: 1u; C_0603_1608Metric; mouser 963-MLAST168SB7105KT
C17: 10u; C_0603_1608Metric; mouser 187-CL10A106MQ8NNND
C18, C19: 22u; C_0603_1608Metric; mouser 187-CL10A226MP8NUNE
D7: STAT1; LED_0603_1608Metric; mouser 710-150060AS75000
D8: BAT54C; SOT-23; mouser 583-BAT54C
D9: STAT2; LED_0603_1608Metric; mouser 710-150060AS75000
D10: PG; LED_0603_1608Metric; mouser 710-150060RS75000
D11: 5v6; D_SOD-123; mouser 78-BZT52C5V6-E3-08
F1: 6V/2A; Fuse_1206_3216Metric; mouser 504-PTS18126V260
L2: 1u; L_0805_2012Metric; mouser 810-MLZ2012N1R0LT000
R14, R15, R16: 470; R_0603_1608Metric; LCSC C23186
R17: 10k; R_0603_1608Metric; LCSC C23186
TH1: 10k; R_0603_1608Metric; mouser 667-ERT-J1VR103J
TP1: 3V3; TestPoint_Pad_D1.5mm; not fitted
TP2: 5V; TestPoint_Pad_D1.5mm; not fitted
U3: MCP73833; DFN-10-1EP_3x3mm_P0.5mm_EP1.58x2.35mm; mouser 579-MCP73833T-AMI/MF
U4: ISL91127IR; QFN-20-1EP_4x4mm_P0.5mm_EP2.7x2.7mm_ThermalVias; mouser 968-ISL91127IRAZ-T

Connections:
+3V3: C18.1, C19.1, TP1.1, U4.15 (FB), U4.17 (VOUT), U4.18 (VOUT), U4.19 (VOUT), U4.20 (VOUT); also elsewhere on the board
+5V: C15.1, D7.2 (A), D8.2, D9.2 (A), D10.2 (A), D11.1 (K), F1.2, TP2.1, U3.1 (V_{DD}), U3.2 (V_{DD})
/BAT: BT1.1 (+), C16.1, D8.1, U3.9 (V_{BAT}), U3.10 (V_{BAT}); also elsewhere on the board
/PWR/BAT_PROG: R17.2, U3.6 (PROG)
/PWR/BAT_THERM: TH1.1, U3.8 (THERM)
/VIN: F1.1; also elsewhere on the board
GND: BT1.2 (-), C15.2, C16.2, C17.2, C18.2, C19.2, D11.2 (A), R17.1, TH1.2, U3.5 (V_{SS}), U3.11 (EP), U4.3 (PGND), U4.13 (SGND), U4.14 (SGND), U4.21 (EPAD); also elsewhere on the board
unnamed: D7.1 (K), R14.2
unnamed: D9.1 (K), R15.2
unnamed: D10.1 (K), R16.2
unnamed: L2.1, U4.4 (LX1), U4.5 (LX1)
unnamed: L2.2, U4.1 (LX2), U4.2 (LX2)
unnamed: R14.1, U3.3 (STAT1)
unnamed: R15.1, U3.4 (STAT2)
unnamed: R16.1, U3.7 (~PG)
unnamed: C17.1, D8.3, U4.6 (PVIN), U4.7 (PVIN), U4.8 (PVIN), U4.9 (PVIN), U4.10 (VIN), U4.11 (EN), U4.12 (MODE)

Notes on the sheet:
AMI-MF
100mA

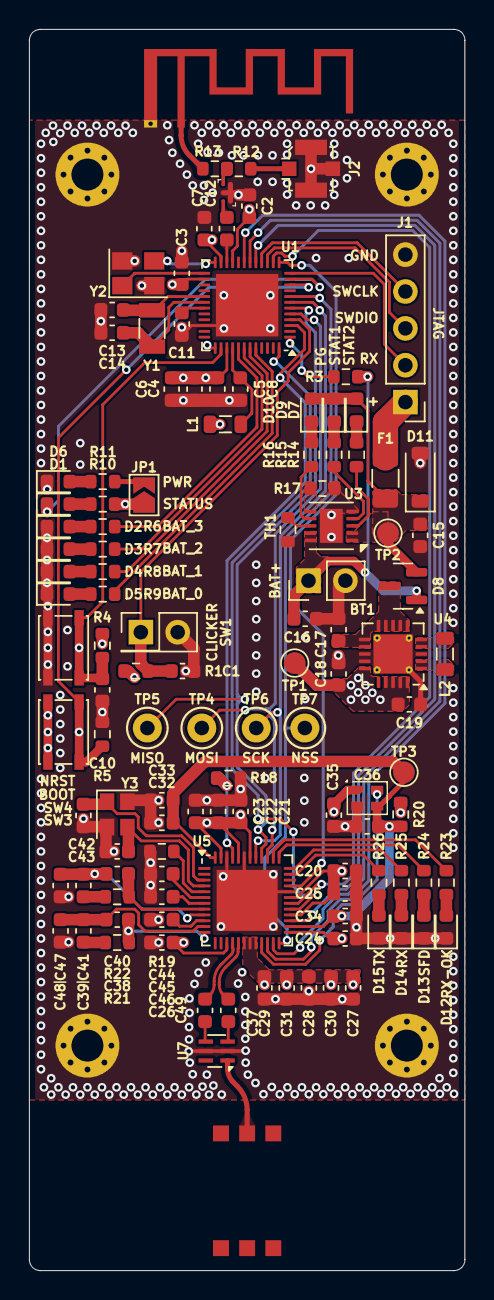
[picture p39: board Clicker_PCB.kicad_pcb from above]

Board: 4 copper layers, 30.0 x 85.5 mm, 122 parts (0 on the bottom side), 84 nets.
