MickThelosen/Smart-Experience-Sampling/Code/Server/Core/Src/main.c

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
/* Includes ------------------------------------------------------------------*/
#include <stdio.h>
#include <string.h>
#include "main.h"

/* USER CODE BEGIN Includes */
#include "DW1000.h"
/* USER CODE END Includes */

/* USER CODE BEGIN PD */

#define MAX_NUM_PACKET          (100)     /* Number of packets used for the test */
#define TX_WAKEUP_TIME          (400)     /* 400 us */
#define RX_WAKEUP_TIME          (380)     /* 300 us */
#define RX_TIMEOUT_ACK          (40000)   /* 400 us */
#define RX_TIMEOUT           	(100000)  /* 100 ms */
#define MAX_BEACON_COUNT 		(40)
/* USER CODE END PD */


SPI_HandleTypeDef hspi2;

UART_HandleTypeDef huart1;

void SystemClock_Config(void);
void PeriphCommonClock_Config(void);
static void MX_GPIO_Init(void);
static void MX_SPI2_Init(void);
static void MX_USART1_UART_Init(void);
static void MX_RADIO_Init(void);
static void MX_RADIO_TIMER_Init(void);
/* USER CODE BEGIN 0 */
DW1000_t dw1000 = { .spi = &hspi2, .NSS_port = GPIOA, .NSS_pin = GPIO_PIN_4,
		.NRST_port = GPIOB, .NRST_pin = GPIO_PIN_10, .tx = 0 };

uint8_t ranging = FALSE;
uint8_t printPacket = FALSE;
uint8_t sendAckData[MAX_PACKET_LENGTH];
uint8_t receivedData[MAX_PACKET_LENGTH];
uint8_t beacon_channel = 0;
/* USER CODE END 0 */

/**
 * @brief  The application entry point.
 * @retval int
 */
int main(void) {

	/* MCU Configuration--------------------------------------------------------*/

	/* Reset of all peripherals, Initializes the Flash interface and the Systick. */
	HAL_Init();

	/* Configure the system clock */
	SystemClock_Config();

	/* Configure the peripherals common clocks */
	PeriphCommonClock_Config();

	/* Initialize all configured peripherals */
	MX_GPIO_Init();
	MX_SPI2_Init();
	MX_USART1_UART_Init();
	MX_RADIO_Init();
	MX_RADIO_TIMER_Init();
	/* USER CODE BEGIN 2 */
	DW1000_init(&dw1000);
	uint8_t pll_lock = DW1000_config(&dw1000, &dw1000_cfg);
	if (pll_lock) {
		hspi2.Init.BaudRatePrescaler = SPI_BAUDRATEPRESCALER_4;
		HAL_SPI_Init(&hspi2);
	}
	uint64_t ID = *((uint64_t*) UID64_BASE);
	uint8_t i = 2;
	sendAckData[0] = 0x1D;
	sendAckData[1] = 8;
	do {
		sendAckData[i++] = ID & 0xFF;
	} while (ID >>= 8);
	HAL_RADIO_SetNetworkID(0x88DF88DF);
	HAL_RADIO_SetTxPower(0x18);
	HAL_RADIO_ReceivePacketWithAck(beacon_channel, RX_WAKEUP_TIME, receivedData,
			sendAckData, RX_TIMEOUT, MAX_LL_PACKET_LENGTH, HAL_RADIO_Callback);

	/* USER CODE END 2 */

	/* Infinite loop */
	/* USER CODE BEGIN WHILE */
	while (1) {
		HAL_RADIO_TIMER_Tick();
		if (ranging == TRUE) {
			double distance = DW1000_responder(&dw1000, beacon_channel);
			uint8_t meters = (uint8_t) distance;
			uint8_t centimeters = (uint8_t) ((distance - meters) * 100);
			if (meters != 0 || centimeters != 0) {
				sendAckData[1] = 10;
				sendAckData[10] = meters;
				sendAckData[11] = centimeters;
				ranging = FALSE;
				distance = 0;
			}
		} else if (printPacket == TRUE) {
			receivedData[receivedData[1]] = 0xFE;
			HAL_UART_Transmit(&huart1, (const uint8_t*) receivedData,
					receivedData[1] + 1, 100);
			printPacket = FALSE;
			memset(receivedData, 0, sizeof receivedData);
		}
		/* USER CODE END WHILE */

		/* USER CODE BEGIN 3 */
	}
	/* USER CODE END 3 */
}

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
/* USER CODE BEGIN 4 */
void HAL_RADIO_CallbackRcvError(RxStats_t *rxPacketStats) {

	HAL_RADIO_ReceivePacketWithAck(beacon_channel, RX_WAKEUP_TIME, receivedData,
			sendAckData, RX_TIMEOUT, MAX_LL_PACKET_LENGTH, HAL_RADIO_Callback);

}

void HAL_RADIO_CallbackRcvTimeout(RxStats_t *rxPacketStats) {

	HAL_RADIO_ReceivePacketWithAck(beacon_channel, RX_WAKEUP_TIME, receivedData,
			sendAckData, RX_TIMEOUT, MAX_LL_PACKET_LENGTH, HAL_RADIO_Callback);

}

void HAL_RADIO_CallbackTxDone(void) {

	HAL_RADIO_ReceivePacketWithAck(beacon_channel, RX_WAKEUP_TIME, receivedData,
			sendAckData, RX_TIMEOUT, MAX_LL_PACKET_LENGTH, HAL_RADIO_Callback);

}

void HAL_RADIO_CallbackRcvOk(RxStats_t *rxPacketStats) {
	if (receivedData[0] == 0x1D) {
		sendAckData[10] = 0;
		sendAckData[11] = 0;
		ranging = TRUE;
	} else if (receivedData[0] == 0xFF) {
		sendAckData[10] = 0;
		sendAckData[11] = 0;
		printPacket = TRUE;
		ranging = FALSE;
	}
	HAL_RADIO_ReceivePacketWithAck(beacon_channel, RX_WAKEUP_TIME, receivedData,
			sendAckData, RX_TIMEOUT, MAX_LL_PACKET_LENGTH, HAL_RADIO_Callback);
}
/* USER CODE END 4 */
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
