MickThelosen/Smart-Experience-Sampling/Code/Clicker/Clicker_Software.ioc

Mcu.UserName=STM32WB07CCVx
PA12.Signal=GPIO_Output
PA13.Signal=SPI1_SCK
PA14.Signal=SPI1_MISO
PA15.Signal=SPI1_MOSI
PA2.Signal=DEBUG_SWDIO
PA3.Signal=DEBUG_SWCLK
PA4.Signal=GPIO_Output
PA5.Signal=SPI2_SCK
PA6.Signal=SPI2_MOSI
PA7.Signal=SPI2_MISO
PB0.Signal=GPXTI0
PB10.Signal=GPIO_Output
PB12.Signal=RCC_OSC32_OUT
PB13.Signal=RCC_OSC32_IN
PB5.Signal=GPXTI5
