MickThelosen/Smart-Experience-Sampling/(commit log)

2025-01-19 All files from the SES project for future use.
    [Clicker V3.1.f3d, Clicker V3.1.step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]
2025-01-27 Updated PCB, Beacon-Visualizer, Code Explaination, User Manual, and added back- & frontend.
    [Clicker_PCB-B_Adhesive.gbr, Clicker_PCB-B_Cu.gbr, Clicker_PCB-B_Mask.gbr, Clicker_PCB-B_Paste.gbr, Clicker_PCB-B_Silks.gbr, Clicker_PCB-B_Silkscreen.gbr, Clicker_PCB-Edge_Cuts.gbr, Clicker_PCB-Edge_Cuts.gm1]
